karver8/freeRTOS-semester-project/Project Summary.pdf

# FreeRTOS Demo Robot

Anthony Savitt & Jacob Carver

# FreeRTOS Features Used

## - Tasks

## - Queues - Semaphores - Timers - ISR Management - FreeRTOS+Tracealyzer - Data Acquisition

# Tasks to Perform and Optimize

1. Get distance data from LIDAR sensor
a. Read data into buffer from 8 bytes
b. Return buffer

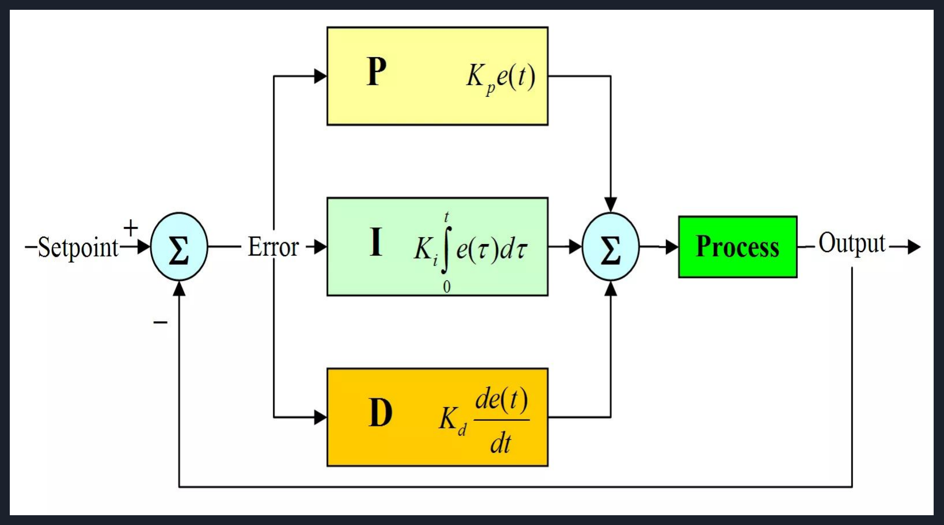
[picture p15: figure]

2. Calculate pwm value from PID loop
a. Our target distance: 40cm
b. Max distance before full speed: 90cm
3. Perform PWM

# Experiment #1 Basic Tasks and Queues

## Bad CPU Utilization Minimal task use

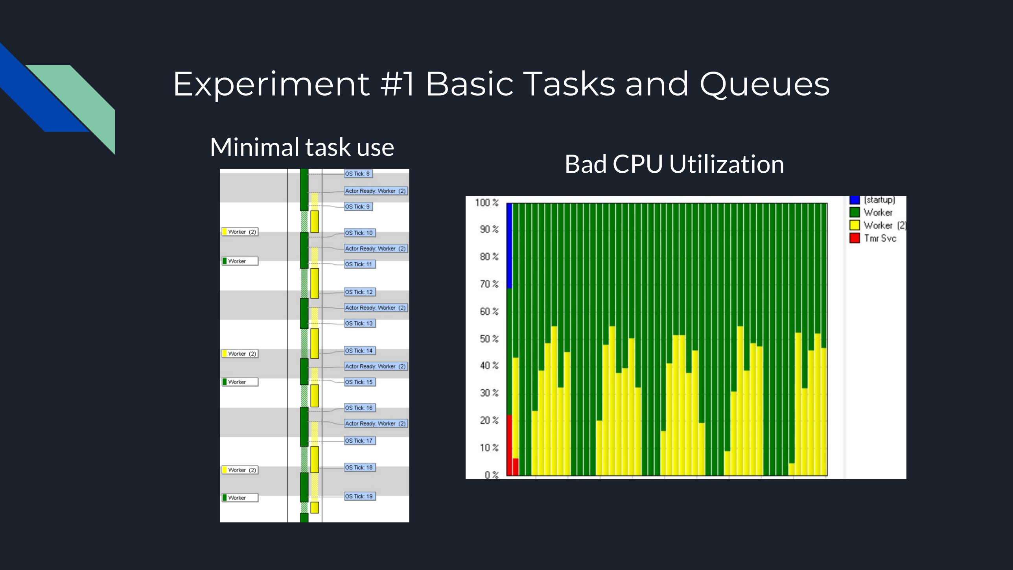
[picture p16: page 4]

# Experiment #2 Improved Tasks and Queues

## Bad CPU Utilization Minimal task use

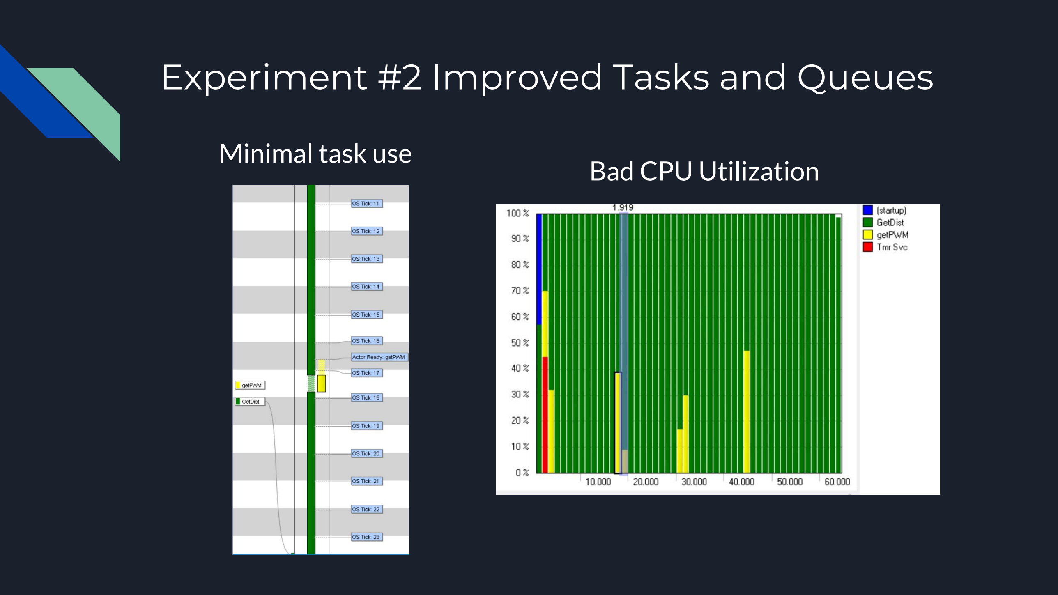
[picture p17: page 5]

# Experiment #3 Callbacks & Semaphores

Lots of Fragmentation

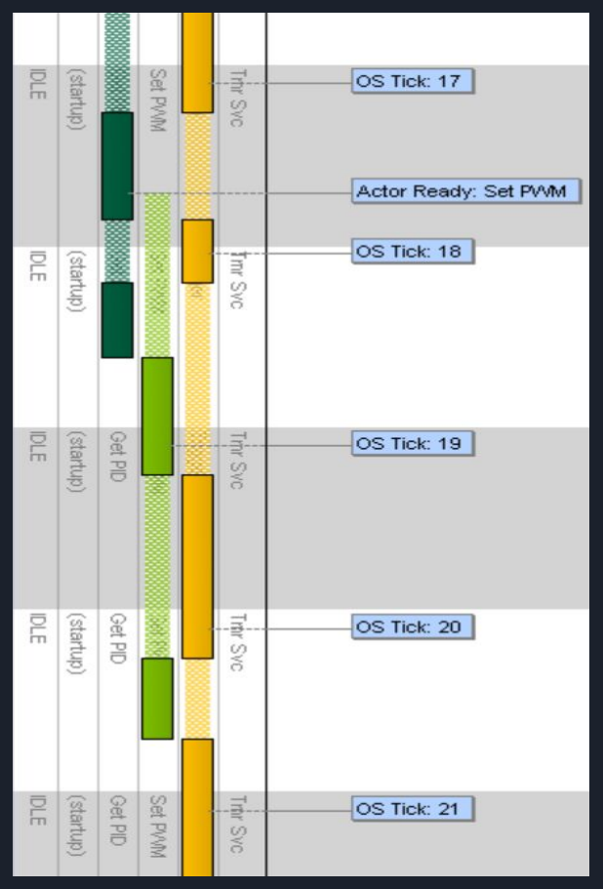
[picture p18: figure]

Test Conditions:
- Utilized USART callback mode
- Use of Semaphores for callback
- Separate Data Queues
Results:
- Improved synchronization.
- Reduced program complexity
- CPU utilization is still inefficient
- Task execution order is chaotic.
- Set PWM Exec: 773µs
- Set PWM Response: 2.169ms

## Bad CPU Utilization

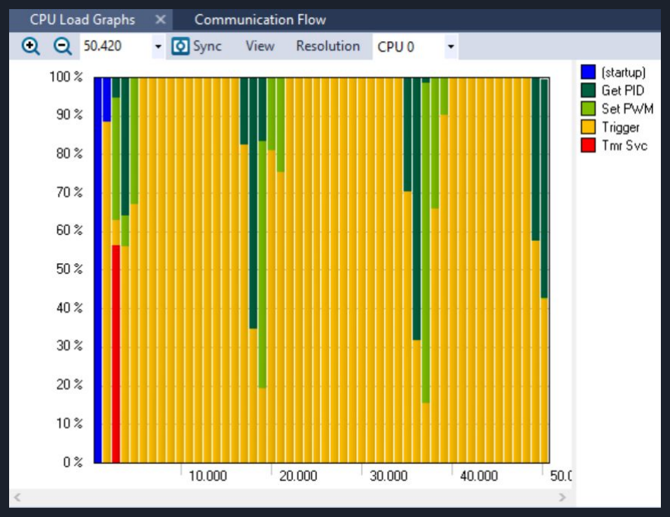
[picture p19: figure]

# Experiment #4 Semaphores w/ Priorities

Improved Execution Order | Test Conditions: ● PID set to Priority 2 ● PWM set to Priority 2 ● RX set to Priority 1( RX < PWM & PID) Results: ● Vital PWM and PID management tasks are no longer interrupted mid execution. ● CPU utilization was not addressed in this experiment. ● SetPWM Exec: 444µs ● SetPWM Response: 787µs ● SetPWM Fragmentation: 1

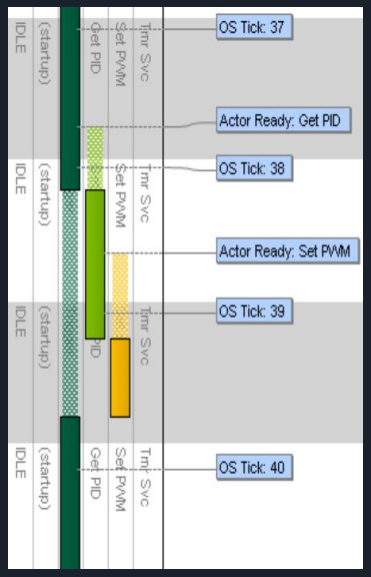
[picture p20: figure]
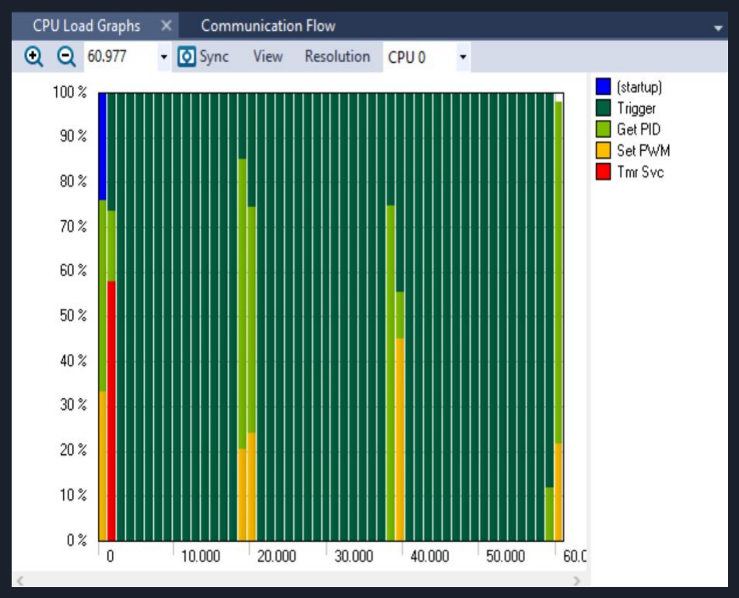
[picture p21: figure]

# Experiment #5 Disabling Preemption

PID Task (Yellow, P2) is Waiting on Trigger(Green, P1)

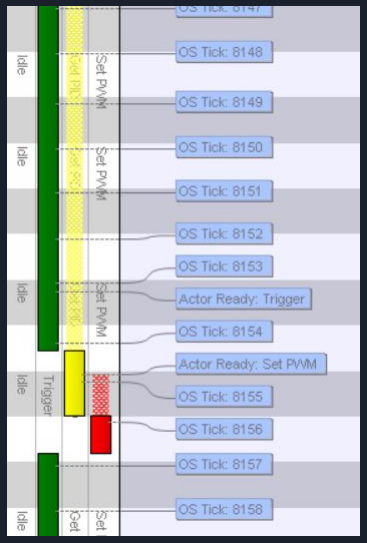
[picture p22: figure]

Test Conditions:
- Same as Experiment #4
- Disabled Preemption in FreeRTOS settings.
Results:
- Preemptive scheduling is a must
- Nothing we didn’t expect

# Experiment #6 Timers(Best Result)

## Minimal CPU Utilization!

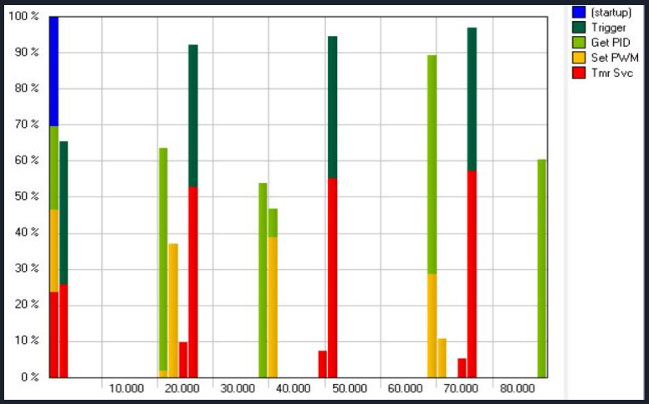
[picture p23: figure]

Test Conditions:
- Added timer to RX
- Removed Semaphores
- Removed unneeded single RX Trigger jobs
- Everything else is the same as Experiment #4

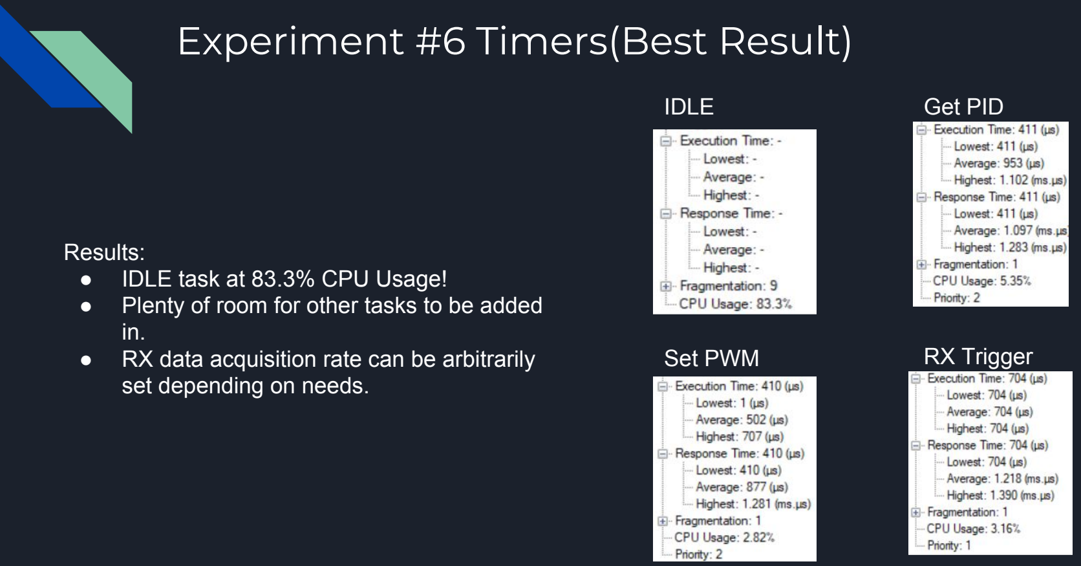
[picture p24: figure]
Experiment #6 Timers(Best Result); IDLE; Get PID; Set PWM; RX Trigger; Results: ● IDLE task at 83.3% CPU Usage!; set depending on needs.

- Plenty of room for other tasks to be added
- RX data acquisition rate can be arbitrarily

# Experiment #6 Timers(Best Result)

## Lots of Available IDLE Time!

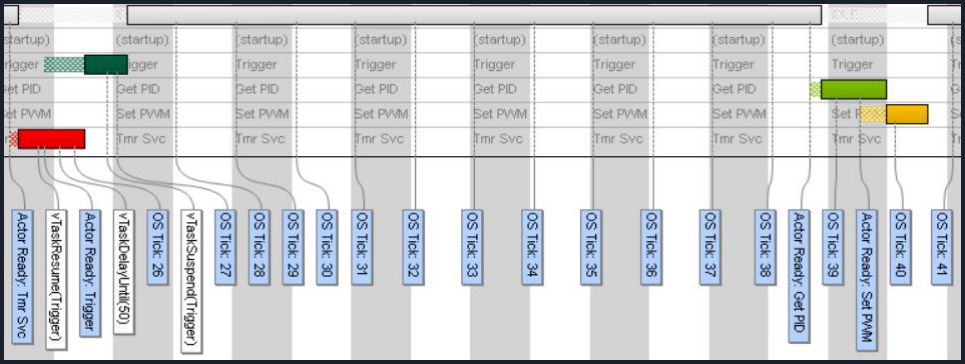
[picture p25: figure]

# Emergency Slide (ONLY IF NECESSARY)

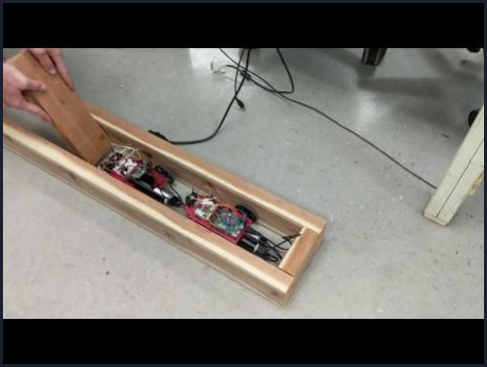
[picture p26: figure]
